Tinzen/METR2800-GROUP1/Claude outputs/v1_sequence_keyframes.png

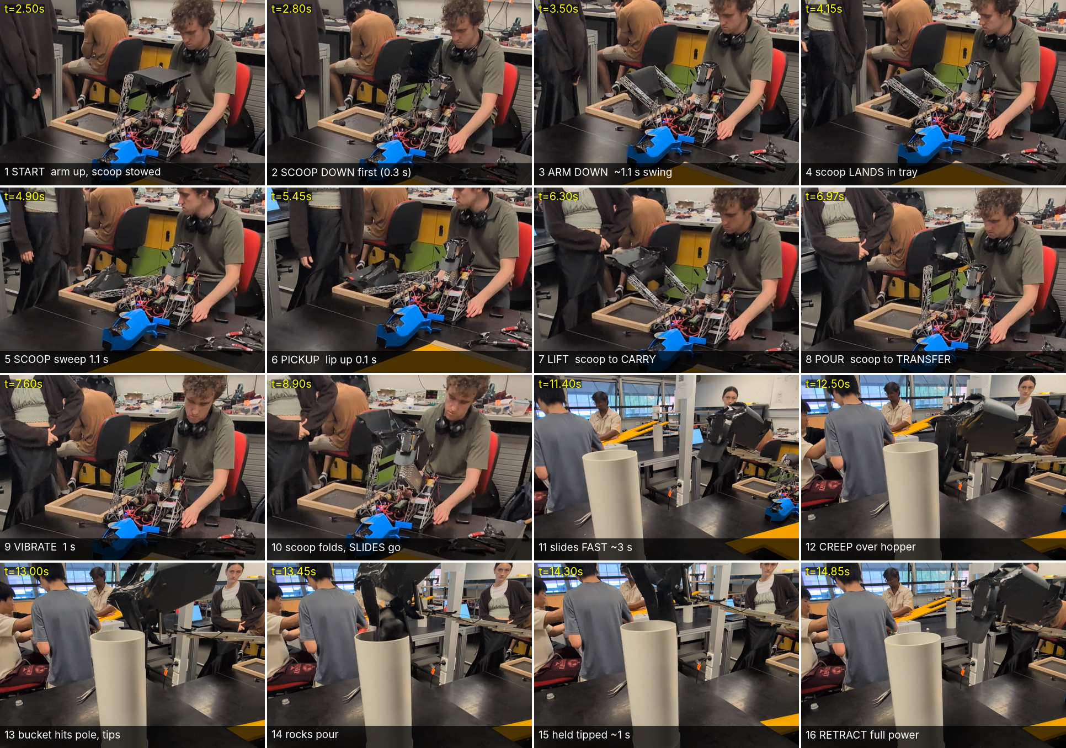
Claude outputs/v1_sequence_keyframes.png
