Tinzen/METR2800-GROUP1/Robot_Controller_V2_1/MotionProfile.h

#ifndef MOTIONPROFILE_H
#define MOTIONPROFILE_H

#include <Arduino.h>

// Trapezoidal / triangular motion profile.
//
// moveTo() behaves exactly like the v1 class (starts and ends at rest).
// moveToVel() can also start and/or end moving, which lets two moves blend
// without stopping in between (slides: fast cruise -> slow creep).
class MotionProfile {
  public:
    MotionProfile();

    // Units are whatever the owner uses (degrees, encoder ticks, ...).
    // maxDeceleration < 0 (default) = the same as maxAcceleration (symmetric trapezoid).
    void setLimits(float maxVelocity, float maxAcceleration, float maxDeceleration = -1.0f);

    float getTarget() const;
    float getCurrent() const;

    void moveTo(float startPosition, float targetPosition);
    // startVel / endVel are speeds (>= 0) in the direction of travel.
    void moveToVel(float startPosition, float targetPosition, float startVel, float endVel);
    // Take over from a move in progress: curVel is its signed velocity now. Same way as the
    // new target = carry the speed in; the other way = brake to a stop first (at maxDec), then go.
    void moveFrom(float startPosition, float targetPosition, float curVel);
    float update();
    bool isFinished() const;

    float getVelocity() const;      // signed units/s at last update()
    float getAcceleration() const;  // signed units/s^2 at last update()
    float getTotalTime() const;     // seconds for the current move (incl. any braking)
    float getTimeLeft() const;      // seconds until the current move is planned to finish (0 = done)
    float getProgress() const;      // 0..1 of distance at last update()
    float getMaxVelocity() const;
    float getMaxAcceleration() const;

  private:
    float maxVel;
    float maxAcc;      // speeding up
    float maxDec;      // slowing down (and braking in moveFrom)

    float startPos;
    float targetPos;
    float currentPos;
    float direction;
    unsigned long startTimeMs;
    float revT;        // moveFrom: braking time before the move (s), 0 = none
    float revV;        //           signed velocity braking starts from
    float revP;        //           position braking starts from

    float totalDist;
    float v0;          // entry speed
    float v1;          // exit speed
    float vPeak;
    float acc1;        // signed accel of phase 1 (+ speeds up, - slows down)
    float dec3;        // decel magnitude of phase 3
    float d1, d2;      // distance of phase 1 and 2 (cruise)
    float t1, t2, t3;
    float totalTime;

    bool done;

    float currentVel;
    float currentAcc;
    float progress;

    void plan();
    void sample(float elapsed, float& dist, float& vel, float& acc) const;
};

#endif
