Tinzen/METR2800-GROUP1/(commit log)

2026-10-12 Servo Testing File
2026-10-13 Updated Servo Positions
2026-10-15 Servo Tester
